urbanpotocnik/konstruiranje-elektronskih-naprav/vaja10/10 - USB DAQ project - microcontroller part and USB part design.pdf

# Construction of Electronic Systems

# Exercise 10: USB DAQ project:

# microcontroller part & USB part design

In this exercise you will design the microcontroller part and the USB part of your PCB. As typically, you will first identify the critical circuit parts and then design these two segments.

## Exercise tasks:

1. Analyze the microcontroller module (Figure 1) and try to identify the critical parts.

Also, consider how the individual circuit components can be used in the most beneficial way to make a better circuit design.

a. Which parts of the microcontroller module are critical?

Advice: go through microcontroller pins and check what kind of signals are connected to them?

i. Which parts generate "digital noise"?

ii. Are there any sensitive pasts?

iii. Are there any high-frequency signals connected to the microcontroller?

b. Which components play an important role in these critical parts of the circuit?
i. Make sure that you know understand their role and know how to use these components properly to create a good circuit design. Use the theory from the lectures.

ii. Are there any components that are critical for a good design and belong near the microcontroller on the PCB but are not in the microcontroller schematics?

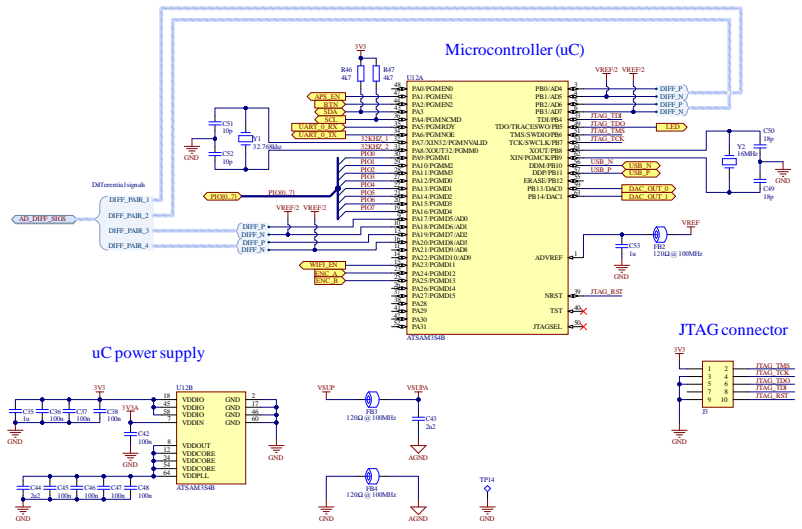
[picture p6: figure]
ADVREF; JTAGSEL; NRST; PA0/PGMEN0 48 PA1/PGMEN1 47 PA2/PGMEN2 44 PA3 43 PA4/PGMNCMD 36 PA5/PGMRDY 35 PA6/PGMNOE 34 PA7/XIN32/PGMNVALID 32 PA8/XOUT32/PGMM0 31 PA9/PGMM1 30 PA10/PGMM2 29 PA11/PGMM3 28 PA12/PGMD0 27 PA13/PGMD1 22 PA14/PGMD2 21 PA15/PGMD3 20 PA16/PGMD4 19 PA17/PGMD5/AD0 9 PA18/PGMD6/AD1 10 PA19/PGMD7/AD2 13 PA20/PGMD8/AD3 16 PA21/PGMD9/AD8 11 PA22/PGMD10/AD9 14 PA23/PGMD11 15 PA24/PGMD12 23 PA25/PGMD13 25 PA26/PGMD14 26 PA27/PGMD15 37 PA28 38 PA29 41 PA30 42 PA31 52; TDI/PB4; TDO/TRACESWO/PB5; TMS/SWDIO/PB6; TCK/SWCLK/PB7; XOUT/PB8; XIN/PGMCK/PB9; DDM/PB10; DDP/PB11; ERASE/PB12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

Figure 1 - the microcontroller module has important critical parts that need to be identified before the PCB design

Construction of Electronic Systems | 2/3

### 2. Similarly, analyze the USB module (Figure 2):

a. Which part prevents noise to propagate over the bus power supply?
b. How does the electrostatic discharge (ESD) protection circuit work?
c. The ESD pulses are fast changing signals. How should the return path for the ESD pulse be designed – in terms of the return path impedance?
d. What is the role of the series resistors R40 and R41?
e. Where should you place the components that are the first components that USB signals reach coming from the USB connector?
f. The USB communication is based on a fast differential signal pair. How should this fast differential signals be routed on the PCB in order to minimize the EMI?

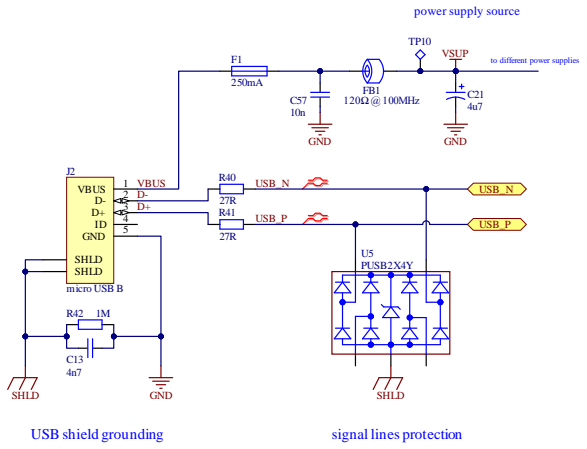
[picture p7: figure]
VBUS; SHLD; GND; micro USB B; USB_N; USB_P; U5 PUSB2X4Y; VSUP; signal lines protection; USB shield grounding; power supply source; to different power supplies; C21 FB1 120Ω @ 100MHz

Figure 2 - you will design the USB part

3. Design the microcontroller module and the USB module.

Advice: make sure that the microcontroller location and orientation are suitable (consider the location of other modules). Then, make a good detailed placement of components. Start with the most critical components and proceed to the less critical components. When you are happy with the component placement, start routing the connections. Again, from the most critical to the less critical. Do not forget to place the ground vias. Try to minimize the segmentation of the ground polygon pour beneath the microprocessor. Use the idea of "fanout routing" to achieve this (see additional materials).

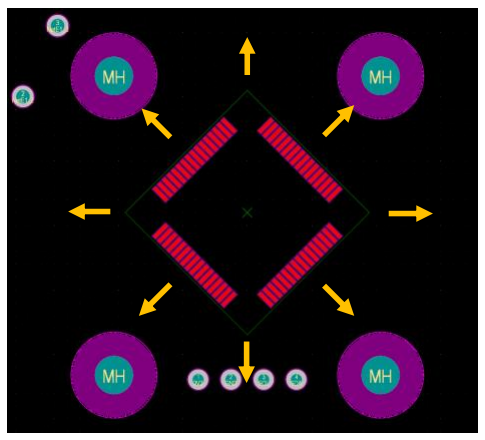
[picture p8: figure]

Figure 3 - deciding where exactly to place the microcontroller so that you will have enough room for all the important components that should be near the microcontroller. The issue here are the obstacles surrounding the microcontroller (i.e. the holes and locked component pins).

Construction of Electronic Systems | 3/3

## Explanation of the exercise

We are moving the focus of our PCB design to the center of the PCB, where you will design the microcontroller part. Microcontrollers are, of course, widely used in electronics: from very simple devices to complex systems. Therefore it is important that you are aware of the potential problems that come with the microcontroller PCB design and that you know how to deal with them.

## Preparation for the lab exercise

You can refresh the knowledge about the bypass capacitors and their appropriate application. (https://www.youtube.com/watch?v=ql7DNz9Rf24&t=1906s)

Also, you can refresh the knowledge about the fast signals and their ground return paths. (https://www.youtube.com/watch?v=PrgH9s7M7k8&t=2398s)
