urbanpotocnik/konstruiranje-elektronskih-naprav/vaja2/maximum brightness circuit.PNG

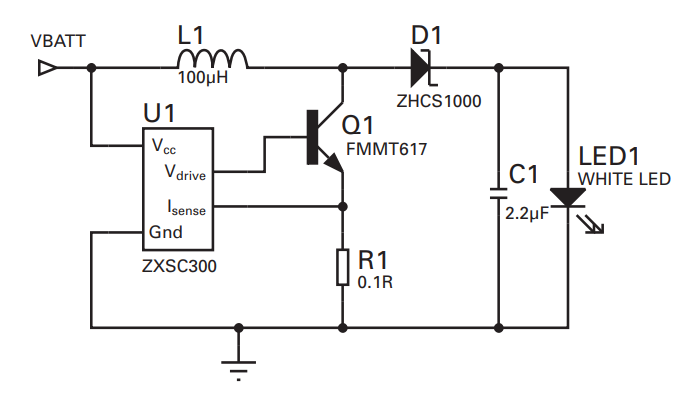
vaja2/maximum brightness circuit.PNG
