urbanpotocnik/konstruiranje-elektronskih-naprav/vaja11/1593L Top.stp

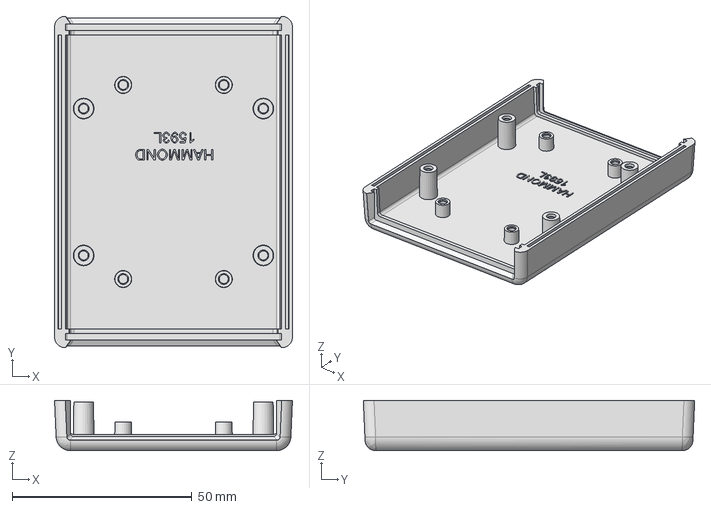
[picture p75: CAD file, 2024-11-13]
vaja11/1593L Top.stp
66.2 x 92.2 x 14.0 mm
