urbanpotocnik/konstruiranje-elektronskih-naprav/vaja11/1593L Endplate.stp

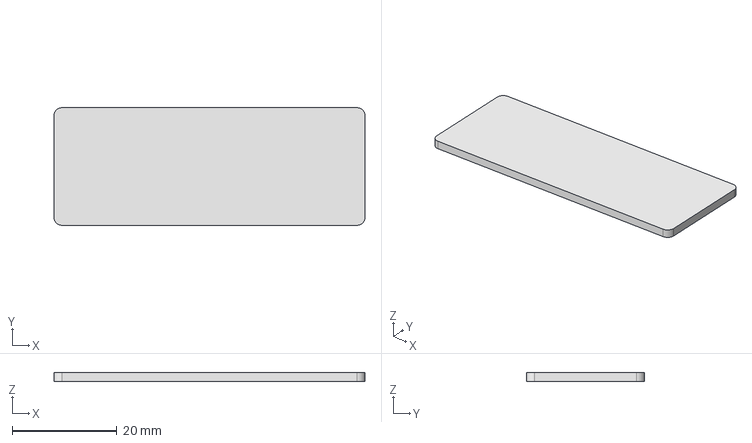
[picture p76: CAD file, 2024-11-13]
vaja11/1593L Endplate.stp
59.5 x 22.5 x 1.70 mm
