urbanpotocnik/konstruiranje-elektronskih-naprav/vaja11/1593L Bottom.stp

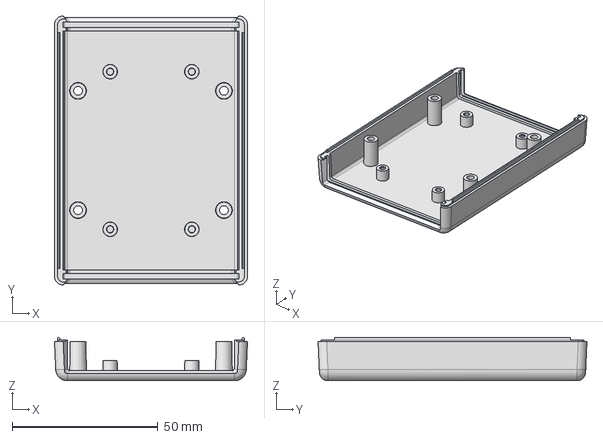
[picture p77: CAD file, 2024-11-13]
vaja11/1593L Bottom.stp
66.2 x 92.2 x 14.9 mm
