urbanpotocnik/konstruiranje-elektronskih-naprav/vaja11/1593L PCB.stp

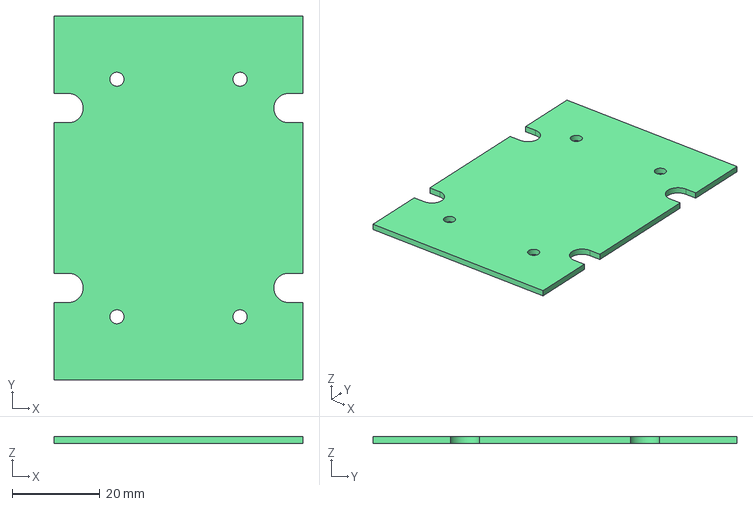
[picture p78: CAD file, 2024-11-13]
vaja11/1593L PCB.stp
56.6 x 82.7 x 1.60 mm
