urbanpotocnik/konstruiranje-elektronskih-naprav/(list of files, drawings)

Other design files:
vaja2/vaja1.PrjPcb
vaja2/vaja1.SchDoc
vaja2/vaja2.PcbDoc
vaja2/ZXSC300.SchLib
vaja3/DAQ_IO.SchDoc
vaja3/DAQ_REV_B.PrjPcb
vaja3/DAQ_REV_B.SchDoc
vaja3/Input_amplifiers.SchDoc
vaja3/Microcontroller.SchDoc
vaja3/Output_amplifier.SchDoc
vaja3/Power_supply.SchDoc
vaja4/DAQ_IO.SchDoc
vaja4/DAQ_REV_B.PcbLib
vaja4/DAQ_REV_B.PrjPcb
vaja4/DAQ_REV_B.SchDoc
vaja4/Input_amplifiers.SchDoc
vaja4/Interfaces.SchDoc
vaja4/Microcontroller.SchDoc
vaja4/Output_amplifier.SchDoc
vaja4/Power_supply.SchDoc
vaja4/Reference_voltage.SchDoc
vaja4/USB.SchDoc
vaja11/Cover_sheet.SchDoc
vaja11/DAQ_IO.SchDoc
vaja11/DAQ_REV_B.PrjPcb
vaja11/DAQ_REV_B.SchDoc
vaja11/Input_amplifiers.SchDoc
vaja11/Interfaces.SchDoc
vaja11/Microcontroller.SchDoc
vaja11/Output_amplifier.SchDoc
vaja11/Power_supply.SchDoc
vaja11/Reference_voltage.SchDoc
vaja11/USB.SchDoc
