urbanpotocnik/konstruiranje-elektronskih-naprav/(commit log)

2024-10-15 Added vaja1
    [ZXSC300.SchLib, vaja1.PrjPcb, vaja1.SchDoc]
2024-10-17 Added vaja2
    [ZXSC300.SchLib, vaja1.PrjPcb, vaja1.SchDoc, vaja2.PcbDoc]
2024-10-22 Finished vaja2
    [vaja2.PcbDoc]
2024-10-26 Added Vaja3
    [Cover_sheet.SchDoc, DAQ_IO.SchDoc, DAQ_REV_B.PrjPcb, DAQ_REV_B.SchDoc, Input_amplifiers.SchDoc, Interfaces.SchDoc, Microcontroller.SchDoc, Output_amplifier.SchDoc]
2024-11-02 Added Vaja4
    [Cover_sheet.SchDoc, DAQ_IO.SchDoc, DAQ_REV_B.PcbLib, DAQ_REV_B.PrjPcb, DAQ_REV_B.SchDoc, Input_amplifiers.SchDoc, Interfaces.SchDoc, Microcontroller.SchDoc]
2024-11-05 Finished vaja 4
    [DAQ_IO.SchDoc, DAQ_REV_B.PrjPcb, Input_amplifiers.SchDoc, Microcontroller.SchDoc]
2024-11-13 Added vaja5
    [1593L Bottom.stp, 1593L Endplate.stp, 1593L PCB.stp, 1593L Top.stp, Cover_sheet.SchDoc, DAQ_IO.SchDoc, DAQ_REV_B.PrjPcb, DAQ_REV_B.SchDoc]
2024-11-14 Added vaja 6
    [1593L Bottom.stp, 1593L Endplate.stp, 1593L PCB.stp, 1593L Top.stp, Cover_sheet.SchDoc, DAQ_IO.SchDoc, DAQ_REV_B.PrjPcb, DAQ_REV_B.SchDoc]
2024-11-28 Added vaja8
    [1593L Bottom.stp, 1593L Endplate.stp, 1593L PCB.stp, 1593L Top.stp, Cover_sheet.SchDoc, DAQ_IO.SchDoc, DAQ_REV_B.PrjPcb, DAQ_REV_B.SchDoc]
2024-11-29 Added vaje9
    [1593L Bottom.stp, 1593L Endplate.stp, 1593L PCB.stp, 1593L Top.stp, Cover_sheet.SchDoc, DAQ_IO.SchDoc, DAQ_REV_B.PrjPcb, DAQ_REV_B.SchDoc]
2024-12-05 Added vaja10
    [1593L Bottom.stp, 1593L Endplate.stp, 1593L PCB.stp, 1593L Top.stp, Cover_sheet.SchDoc, DAQ_IO.SchDoc, DAQ_REV_B.PrjPcb, DAQ_REV_B.SchDoc]
2024-12-18 Made half of the vaja11
    [1593L Bottom.stp, 1593L Endplate.stp, 1593L PCB.stp, 1593L Top.stp, Cover_sheet.SchDoc, DAQ_IO.SchDoc, DAQ_REV_B.PrjPcb, DAQ_REV_B.SchDoc]
2024-12-19 Finished vaja1
    [DAQ_REV_B.PrjPcb]
